JJKSweaty/jjkVR/README.md

# jjkVR

A custom, wired PC VR headset — built from a bare IMU chip up through SteamVR integration.

`Status: In progress (hardware, firmware, and driver bring-up)`

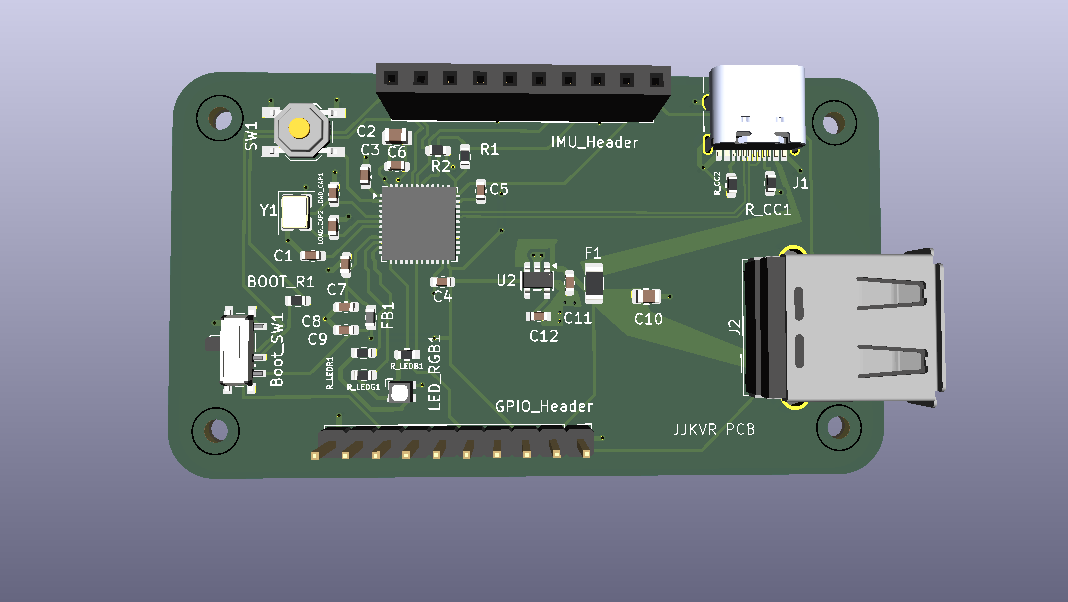
[picture p1: vr_custom_pcb.png]
jjkVR custom STM32F411 tracking PCB


*Custom STM32F411 tracking and interface PCB designed in KiCad.*

## What it is

jjkVR is a DIY PC VR headset that pairs a custom embedded tracking board with a high-refresh display path and full SteamVR/OpenVR support. Rather than wrapping an existing headset or dev kit, it implements the entire pose-tracking chain from scratch: a 9-DoF IMU feeds an STM32F411 microcontroller, which runs sensor fusion and streams orientation data to the PC over USB HID, where a custom OpenVR driver hands it to SteamVR. The display side takes GPU output over HDMI/DisplayPort and converts it to drive a 2K 120Hz panel.

It's inspired by (and builds on ideas from) [Relativty](https://github.com/relativty/Relativty) and [HadesVR](https://github.com/UkonnRa/HadesVR), two other open-source HMD projects.

## Why

Commercial VR headsets are closed systems — the tracking hardware, firmware, and drivers are black boxes. jjkVR exists to make every layer of that stack inspectable and hackable: the PCB is your own design, the firmware is yours to modify, and the SteamVR driver is yours to extend. It's a project for understanding *how* headset tracking actually works, not just using one, and for having a hardware/software platform you can freely tinker with, calibrate, and rebuild.

## How it works

```text
[ICM20948 IMU + TF-Luna] --I2C--> [STM32F411 MCU] --USB HID--> [SteamVR/OpenVR Driver]

[PC GPU] --HDMI/DP--> [Display Driver Board] --> [2K 120Hz HMD Panel]
```

* The **ICM20948** IMU reports raw accelerometer, gyroscope, and magnetometer data over I2C.
* The **STM32F411** reads that data, calibrates stationary accel/gyro bias at startup, and runs float Mahony sensor fusion.
* Orientation and bounded experimental inertial position are packed into **USB HID reports**; an optional rigidly mounted TF-Luna can correct only forward position.
* A **custom OpenVR driver** (adapted from Relativty's) parses those HID reports and feeds pose data into SteamVR.
* Separately, the PC's GPU output is converted by a **display driver board** to drive the **2K 120Hz HMD panel**.

The reliable target remains wired **3-DoF orientation tracking**. IMU translation is a short-motion experiment, not drift-free room-scale 6-DoF; the architecture leaves room for an external positional reference later.

## Features

* Custom HMD controller PCB (not an off-the-shelf dev board)
* 9-axis IMU sensor fusion in compact HAL-native C
* USB HID pose streaming with a defined custom report format
* SteamVR/OpenVR integration through a Relativty-derived driver
* 2K 120Hz display target with a dedicated HDMI/DP-to-MIPI driver board
* Stationary accel/gyro calibration at every boot
* Status LEDs for calibration, IMU fault, and tracking state

## Hardware

| Component | Purpose |
| --- | --- |
| STM32F411 | Main MCU — IMU reads, sensor fusion, calibration, USB HID |
| ICM20948 | 9-axis IMU (accelerometer, gyroscope, magnetometer) |
| TF-Luna | Optional forward range correction after rigid mounting |
| Custom PCB | Integrates MCU, IMU interface, USB-C, regulator, LEDs, test points |
| 2K 120Hz display | Main HMD panel |
| HDMI/DP-to-MIPI driver board | Converts PC GPU output for the headset panel |
| USB-C | Wired power and USB HID data link |

The PCB itself is designed in KiCad and includes USB-C with proper CC resistors, a protected 3.3V rail, IMU power filtering, short/clean I2C routing with pullups, test points (SDA, SCL, 3V3, GND, USB), a status LED, and an expansion header for future accessories.

## Tech stack

* **Firmware:** C11, STM32F411 Cube HAL/CMake, float Mahony fusion
* **Sensors:** ICM20948, I2C, 9-DoF sensor fusion
* **USB:** USB HID pose reports
* **PCB:** KiCad, USB-C, 3.3V regulation
* **PC software:** SteamVR, OpenVR, Relativty driver architecture
* **Display:** 2K 120Hz panel with HDMI/DP-to-MIPI conversion

## Acknowledgments

* [Relativty](https://github.com/relativty/Relativty) — open-source VR headset and OpenVR driver reference
* [HadesVR](https://github.com/UkonnRa/HadesVR) — open-source HMD and tracking reference
* [FastIMU](https://github.com/LiquidCGS/FastIMU) — ICM-20948 register and fusion reference
* SteamVR / OpenVR — driver architecture jjkVR integrates with
