JJKSweaty/jjkVR/jjkVRDriver/jjkvr/resources/rendermodels/generic_hmd/generic_hmd.obj

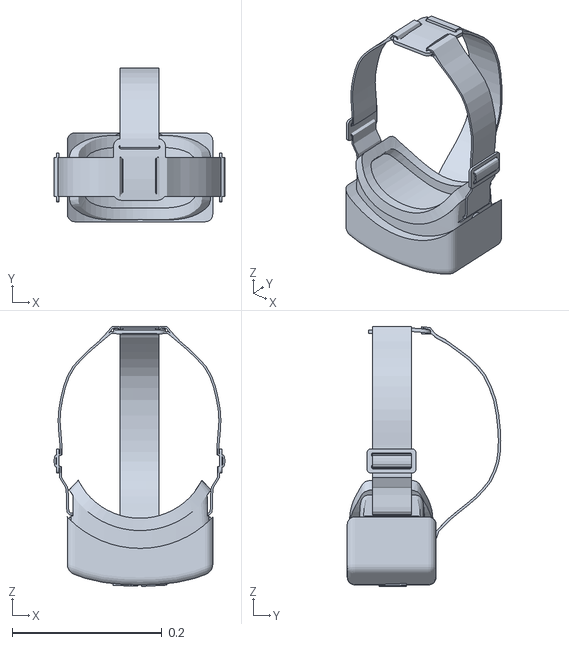
[picture p2: CAD file, 2026-08-10, last stored version]
jjkVRDriver/jjkvr/resources/rendermodels/generic_hmd/generic_hmd.obj
0.228 x 0.205 x 0.348
