JJKSweaty/jjkVR/jjkVRDriver/jjkvr/resources/rendermodels/jjkvr_hand_right/jjkvr_hand_right.obj

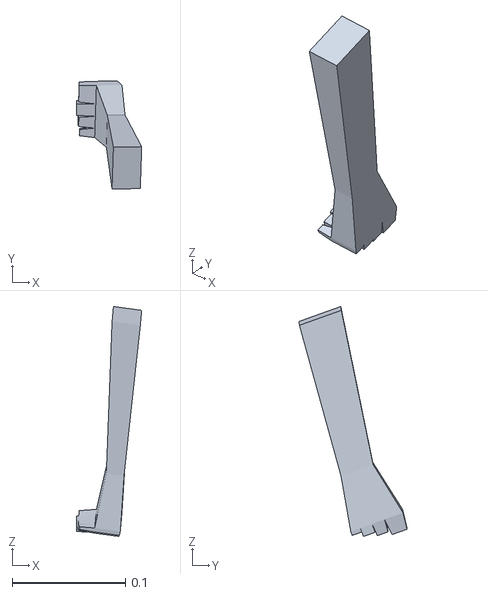
[picture p3: CAD file, 2026-08-12, last stored version]
jjkVRDriver/jjkvr/resources/rendermodels/jjkvr_hand_right/jjkvr_hand_right.obj
0.0578 x 0.0955 x 0.203
