JJKSweaty/jjkVR/vr_f411firmware/vr_f411firmware.ioc

Mcu.UserName=STM32F411CEUx
PA0-WKUP.GPIO_Label=LED_R
PA0-WKUP.Signal=GPIO_Output
PA1.GPIO_Label=LED_G
PA1.Signal=GPIO_Output
PA11.Signal=USB_OTG_FS_DM
PA12.Signal=USB_OTG_FS_DP
PA13.Signal=SYS_JTMS-SWDIO
PA14.Signal=SYS_JTCK-SWCLK
PA2.GPIO_Label=IR_LED_EN
PA2.Signal=GPIO_Output
PA3.Signal=USART2_RX
PB0.GPIO_Label=LED_B
PB0.Signal=GPIO_Output
PB1.GPIO_Label=GPIO_SPARE2
PB1.Signal=GPIO_Input
PB6.Signal=I2C1_SCL
PB7.Signal=I2C1_SDA
PC13-ANTI_TAMP.GPIO_Label=BTN_CAL
PC13-ANTI_TAMP.Signal=GPXTI13
