JJKSweaty/jjkVR/(commit log)

2026-07-05 firmware init for stm32f411
2026-07-05 imu finder code
2026-07-08 stm32f411 firmware reconfig and clk config new pin outputs initializiation with some test code
2026-07-09 calib interrupt change in stm32 config
2026-08-03 Added gerber files and pcb picture
2026-08-07 lidar code init
2026-08-10 jjkvr driver added and LIDAR tracking
    [generic_hmd.obj]
2026-08-10 vr driver adding custom cursor
    [generic_hmd.obj]
2026-08-10 More robust driver mechanics and cursor control
2026-08-10 cursor improvement driver
2026-08-12 imu sensor fusion init
    [generic_hmd.obj, jjkvr_hand_right.obj]
2026-08-12 custom controller objects
    [jjkvr_hand_right.obj]
2026-08-12 Improved controller drivers
    [jjkvr_hand_right.obj]
2026-08-12 IMU & LIDAR Sensor fusion
2026-08-12 No xyz cus of drift improved drivers and lidar switched to UART as 3.3v and 5v cant be on same i2c line
    [main.c, pose_fusion.c, pose_fusion_test.c]
