JJKSweaty/jjkVR/(notices)

Notices in the files:
vr_f411firmware/Core/Inc/main.h:
Copyright (c) 2026 STMicroelectronics.
All rights reserved.
This software is licensed under terms that can be found in the LICENSE file
jjkVRDriver/jjkvr/resources/rendermodels/jjkvr_hand_right/jjkvr_hand_right.obj:
Geometry extracted from "Low Poly FPS Rifle and Hands" by Robin Lamb (CC0).
